trebuHE/PDM-DIC-RS/docs/system_block_diagram.png

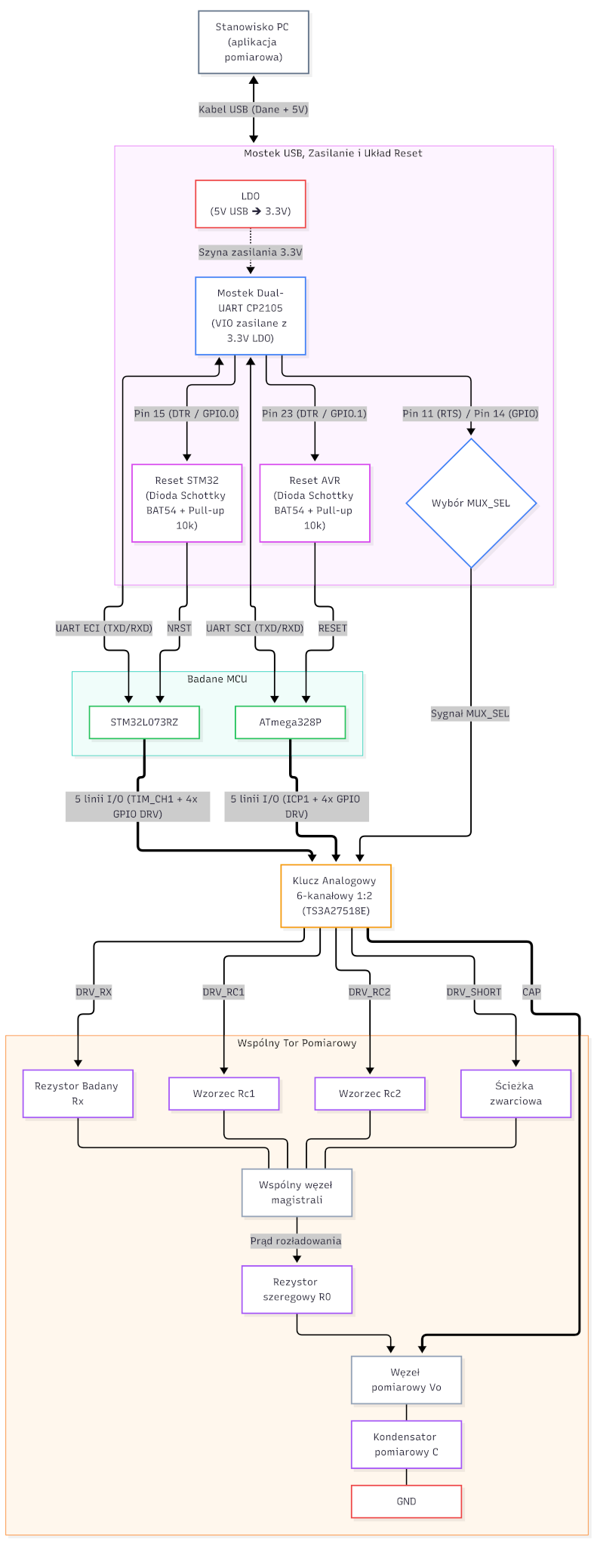
docs/system_block_diagram.png
