trebuHE/PDM-DIC-RS/(commit log)

2026-11-13 Revise reset section, add open-drain reset config as prefferd over diode on reset line
2026-11-13 create kicad project
2026-11-13 add usb and power section
2026-11-13 add power LED
2026-11-13 add usb <--> uart bridge
2026-11-14 update power section, add ESD protection, swap FB for R
2026-11-14 add atmega328p minimal circuit and isp connector
2026-11-14 add reset circuit
